jeremymatthewwerner/halloween-watchful-creature/README.md

# 🎃 Halloween Watchful Creature

A friendly talking porch decoration. It **sees** trick-or-treaters, **compliments their costumes** with kid-friendly jokes, and **chats** with them, powered by OpenAI **GPT-Live**. Its LED eyes glow, pulse and sparkle while it talks. How spooky it gets is up to you (the **Spookiness** dial).

The first character is **Jacques O'Lantern, Pumpkin Critic**: a dapper pumpkin in a top hat, round spectacles and a bow tie who gives every costume a big, silly verdict ("a gold medal!", "three thumbs up, and I don't even have thumbs!"). He talks kid-first, in simple words, and only does his full fancy-food-critic routine for grown-ups who play along. Sir Reginald Bonesworth (skeleton butler) and Edgar the Raven (rhyming critic) are included, and you can switch characters from the dashboard.

**What it does**
- **Greets fast:** starts waking the moment someone appears, says a quick hello while the camera's look is still being described, then praises each costume's **standout detail**.
- **Keeps big groups moving:** for 4 or more visitors, or a group that keeps growing into a line, it gives one quick group welcome, a shout-out to one or two standout costumes and a group moment ("everybody say trick or treat!"), with no mini-game, instead of going costume by costume.
- **Notices change:** new visitors, a second person joining, someone swapping in, and the same person back in a different hat (a playful remark), or back soon (silence) or after a while (a "welcome back").
- **Doesn't repeat itself:** remembers what it said tonight across voice sessions, varies its openings and verdicts, and keeps running gags ("visitor number 50!", "the fourth dinosaur tonight!").
- **Plays:** an occasional riddle for "trick", a roar contest, or "guess what I am".
- **Lets you steer:** quick modes (Candy's low/out, Toddler mode, Back in 5, Last call), a spookiness dial, a voice picker, a kill switch and "make it say…", from the dashboard or **your phone**.
- **Looks after itself:** a watchdog recovers a stuck camera or page, and alerts can **push to your phone**. If Wi-Fi or OpenAI goes down, it greets visitors with **recorded greetings** and switches back to its live voice by itself.
- **Keeps a record:** a daily log with a snapshot of each greeting, a **costume gallery** for the family, and a **night recap** (groups, busiest half hour, top costumes, best lines), with one push to your phone when the night is over.
- **Rehearsal mode:** test greetings with sample photos, without walking in and out of frame.

| Doc | What's in it |
|---|---|
| [docs/PLAN.md](docs/PLAN.md) | Goals, decisions, milestones |
| [docs/DESIGN.md](docs/DESIGN.md) | Architecture, behavior, engines, body protocol |
| [docs/BOM.md](docs/BOM.md) | Bill of materials |
| [docs/SHOPPING_LIST.md](docs/SHOPPING_LIST.md) | Where to buy everything (Burlingame, CA route) |
| [docs/PROP_BUILD.md](docs/PROP_BUILD.md) | Building the pumpkin, wiring the eyes, porch checklist |
| [docs/templates/pumpkin-carving-template.pdf](docs/templates/pumpkin-carving-template.pdf) | Printable, actual-size carving template |
| [docs/PI_MODE.md](docs/PI_MODE.md) | Running on a Raspberry Pi 5 |
| [docs/SOAK_TEST.md](docs/SOAK_TEST.md) | The soak test: a whole evening at high speed, against a mock OpenAI |

## Quick start (Mac)

1. **Install Node.js 22+**. To keep it isolated from the rest of your Mac, use [nvm](https://github.com/nvm-sh/nvm): it installs to `~/.nvm`, no sudo needed. Run `nvm install && nvm use` in the project folder, which picks up `.nvmrc`. Or use `brew install node`, or the installer from nodejs.org. Also install **Google Chrome**. All project dependencies install into `./node_modules` only.
2. **Get the code and install dependencies:**
   ```bash
   git clone https://github.com/jeremymatthewwerner/halloween-watchful-creature.git
   cd halloween-watchful-creature
   npm install
   cp .env.example .env
   ```
3. **Add your OpenAI key:** edit `.env` and set `OPENAI_API_KEY=sk-...`. Also set a monthly spend limit on the OpenAI project.
4. **Check your setup** (Node, key, model access, a test vision call, Arduino):
   ```bash
   npm run doctor
   ```
5. **Run it:**
   ```bash
   npm run dev
   ```
6. **Open Chrome at http://localhost:5173**, click **🎃 Wake the creature**, and allow camera and microphone access.
7. **Walk up to the camera.** It greets you and compliments your outfit. Try asking "what am I dressed as?" or "tell me a joke".

The Mac's built-in camera and mic are fine for testing. Once the porch gear is plugged in (the C920 webcam, whose built-in mics are the ears, and the speakers on a USB sound card; a USB speakerphone works too), choose them under **Settings** on the dashboard. Your choices are remembered by name, so re-plugging into another port or hub is fine.

### Halloween night
```bash
npm run build
caffeinate -dis npm start     # keeps the Mac awake; serves the dashboard at http://localhost:8787
```
Then open **http://localhost:8787** in Chrome and click **Wake the creature**. For an unattended night, start Chrome with the autoplay flag shown under **Watchdog** below, so it can wake itself after a reload, and set up the **phone remote and alerts**.

## Dashboard
- **Live video** with person boxes: green means close enough to greet, grey means too far. Tune the distance with **Settings → How close counts as a visitor**.
- **Status pills:**
  - engine;
  - session state (asleep, connecting, awake);
  - body state (sleeping, idle, listening, thinking, speaking);
  - running **cost**.
- **Eye preview:** an on-screen copy of the two NeoPixel Jewels, pixel by pixel, using the same colors and animations as the firmware, so you can test without the Arduino.
- **👋 Greet now:** forces a greeting.
- **🛑 Sleep (kill switch):** ends the voice session and ignores visitors until you press Wake.
- **Quick modes:** one-tap buttons that change how the creature acts until you tap them again. A lit button (marked **ON**) is on. They're remembered for the evening, even if you reload the page, and are sent again each time a new voice session starts.
  - **🍬 Candy's low:** asks everyone to take just one piece.
  - **🚫 Candy's out:** says sorry, kindly, that the candy is gone, and still compliments costumes.
  - **🧸 Toddler mode:** extra gentle, nothing spooky, very short lines.
  - **⏳ Back in 5:** tells visitors the candy helpers will be back in a few minutes.
  - **🌙 Last call:** greets as usual, then says a warm goodnight.

  Each tap is noted in the Conversation panel and today's log.
- **Spookiness:** a dial under the quick modes for how spooky the creature is tonight. It works the same way as the quick modes: it applies right away, is sent again to each new voice session, and is remembered for the evening.
  - **🌼 Gentle (0):** cheerful and sweet, nothing scary at all.
  - **🎃 Playful (1, the default):** the creature's normal, light spooky fun.
  - **👻 Spooky (2):** eerie voice moments, creaky laughs and spooky jokes, then friendly again.
  - **🦇 Scary (teens) (3):** creepier and more dramatic, but never gory, cruel or mean. If a young child walks up, or anyone seems scared or says so, it switches to gentle by itself.
  - **🕰️ Auto:** follows the clock: gentle until 7 pm, playful from 7, spooky from 8 pm. Auto never picks Scary.

  The level also flavors the greetings' variety twists (a sunny hello when gentle, an eerie pause or a ghost-story line when spooky or scary). **🧸 Toddler mode** wins over the dial: while it's on, the creature is gentle (plus tiny words and very short lines), whatever the dial says, and goes back to the dial's level when you turn it off. Gentle is for a calm evening; Toddler mode is for when very little kids are at the door.
- **Make it say…:** type a line and the creature says it in character.
- **Voice:** a picker listing every voice the current engine can use. Each shows what OpenAI's docs say about it (for GPT-Live: language, regional influence, presentation and source; the docs don't describe tone) and our own notes from testing. English voices come first; the other-language voices carry their language's accent.
  - The voice in effect is marked **current**, with where it comes from. Order: your pick here (remembered in this browser, per engine) > `VOICE` in `.env` > the character's default. **Use default** forgets your pick.
  - A new voice starts with the next voice session. While a session is running with another voice, **🔄 Restart voice session now** ends it; if visitors are there it reconnects right away with the new voice.
  - The server only accepts voices on its list (`shared/voices.ts`); anything else is ignored and logged.
- **Conversation:** live transcript plus system notes.
- **Server log:** the server's terminal output, live. Its links open **today's log**, today's **costume gallery**, the **night recap** and **all logs**. Under them: whether snapshots are on and how long they're kept, and **🗑️ Delete all snapshots now** (see **Privacy** below).
- **Alerts:** health problems (see below), shown only when there are any.
- **Between visitors** (both free: local audio only, they never open the voice session), each with a toggle in **Settings** that's remembered:
  - **Spooky sounds:** every 20–60 s on an empty porch, a quiet creaky door, owl, distant thunder, wind, cackle, wolf howl or church bell, synthesized in the browser (no audio files).
  - **Call out to people walking by (lure mode):** when someone is in view but too far to count as a visitor (a grey box), the pumpkin plays one of 14 recorded call-outs ("Psst! Over here! Come get your costume reviewed!"), never the same one twice in a row, at most once per **Seconds between call-outs** (default 45, plus up to 15 s at random). It waits 30 s after visitors leave or the creature talks, so it doesn't call back kids who just left.
  - Both stop the instant someone comes close or the creature speaks, stay silent while the kill switch is on, and play through the selected **Speaker**.
  - **Eyes:** during a call-out the eyes (and jaw) pulse with the recording, as they do with the live voice. Ambience only gets a blink.
- **Recorded clips in the creature's voice:** call-outs and offline greetings are read by OpenAI text-to-speech (`gpt-4o-mini-tts`), whose voices aren't GPT-Live's. When the dashboard wakes, and whenever you pick a voice, the server makes the clips in the closest TTS voice (about a cent, once per voice), caches them in `clip-cache/` (gitignored; `CLIP_CACHE_DIR`, `none` turns this off) and the dashboard switches to them. Until then, or if that isn't possible (no key, no network, a voice it knows nothing about), it uses the bundled clips (voice `cedar`). The mapping is in [docs/DESIGN.md](docs/DESIGN.md) ("Recorded clips in the session voice"): for example `ripple` is read by `cedar` with a light Australian accent. Making clips is dashboard-only: the phone remote can't trigger it.

### Offline mode (Wi-Fi or OpenAI down)
If the voice session can't start (an error, no network, or no connection within 5 s of a visitor arriving), or it drops mid-visit and won't come back, the pumpkin plays one of 16 short **recorded greetings** ("Happy Halloween! Ooh, what a great costume!") instead of going silent, with its eyes pulsing to the recording.
- Never the same greeting twice in a row, and at most one every 20 s (a group stepping out and back doesn't get a string of them).
- It keeps trying the live voice in the background, after 5 s, then 10, 20, 40 and every 60 s, and switches back the moment it works: visitors who only heard a recording then get a proper live greeting. With the porch empty, a successful check closes the session again right away.
- The status pill shows **offline: recorded greetings**. Going offline and coming back are logged in the Conversation panel and the server log, and raise a **Voice offline** alert (pushed to your phone at most once per 15 minutes, however often it flaps). While offline, the watchdog's separate "voice session failing" alert is held back.

## Phone remote and alerts
Watch and steer the creature from the couch, and get a push on your phone when something breaks. The dashboard on the creature's computer stays the brain: the phone's buttons go through the server to the dashboard, and its status comes back the same way.

### Phone remote
1. In `.env`, set a PIN of at least 6 characters (longer is better), then restart the server:
   ```
   REMOTE_PIN=pick-something-long
   ```
   With a PIN set, the server also listens on your home network (all interfaces, same port). Without one, it only answers this computer, as before.
2. Find the computer's address: on a Mac, **System Settings → Wi-Fi → Details** (or `ipconfig getifaddr en0`); on the Pi, `hostname -I`.
3. On your phone, on the same Wi-Fi, open **`http://<that address>:8787/remote`** and enter the PIN. Tip: add it to your home screen.
   - This works the same in development (`npm run dev`) and on Halloween night (`npm start`): the phone always talks to the server on port 8787, never to the Vite dev server on 5173 (that one only serves this computer, since it hands out project files without a PIN).
   - macOS may ask whether to allow incoming connections for `node`: allow it.

The remote shows whether the creature is awake, asleep (kill switch) or waiting for a tap, visitors at the door, the voice session, the Arduino, today's awake minutes and estimated cost, and the latest alerts. Its buttons: **🛑 Sleep / ▶️ Wake** (the kill switch), **👋 Greet now**, **Make it say…**, the **quick modes**, and links to today's log, the costume gallery, the night recap and all logs.

**Security:**
- LAN access is off unless `REMOTE_PIN` is set. Setting `HOST=0.0.0.0` without a PIN is ignored (the server stays on 127.0.0.1 and says so). `HOST` can still pick a specific address when a PIN is set.
- Every request from another device needs a signed-in session: all `/api` routes (including logs, snapshots and galleries), the `/recap` pages and the `/ws` socket. Only the PIN page and the PIN check itself are open; a page opened without a session (like the recap link in a push) goes to the PIN page first. The dashboard on the creature's computer (loopback, addressed as `localhost`) needs no PIN.
- The PIN is sent once, in the body of a POST, and swapped for an `HttpOnly`, `SameSite=Strict` session cookie (24 hours; restarting the server signs phones out). It's compared in constant time and never logged or put in a URL.
- Wrong PINs: 5 per phone per 15 minutes, and 20 from all devices together, then sign-in locks for the rest of the 15 minutes.
- Even signed in, the phone can't use the dashboard-only routes: it can't start voice sessions, call the vision model, drive the Arduino or delete snapshots. The existing origin check still applies.
- It's plain HTTP on your home network, so anyone who can watch your Wi-Fi traffic could see the PIN and cookie. Use it on a home network you trust, not on public Wi-Fi.

### Watchdog
The dashboard watches itself and recovers:
- **Camera frames stopped:** it restarts the camera; if frames don't come back within 20 s, it reloads the page.
- **Person detector errors** (many in a row, or it failed to load): reloads.
- **Voice session failing to start** 5 times in a row: alerts, and reloads if this computer is known to wake without a click (see below).
- **Page frozen:** a frozen page can't fix itself. The dashboard checks in with the server every 2 s; after 45 s of silence the server raises an alert. On the Pi, `scripts/pi/kiosk.sh` also restarts Chromium when the dashboard has been silent for 90 s.

At most 3 automatic reloads per hour (never in the first minute after loading), then it only alerts. A page that was awake in the last 15 minutes wakes again by itself after a reload, with the kill switch as it was.

**Sound after a reload:** browsers block sound until someone clicks the page. If that happens, the dashboard waits, shows *Click to wake* and raises a **Dashboard needs a tap** alert. Pressing **Wake** on the remote retries, but a tap on the phone can't unblock sound on another device's browser: someone has to click the dashboard once. For unattended use, start Chrome with:
```bash
# Mac
open -na "Google Chrome" --args --autoplay-policy=no-user-gesture-required "http://localhost:8787/?autowake"
```
The Pi kiosk already uses this flag. The setting only lasts while that Chrome window runs, so quit Chrome fully first.

### Alerts
Alerts show on the dashboard and the remote: camera lost, person detector failed, Arduino disconnected, vision errors piling up, voice session failing, voice offline (playing recorded greetings), daily cost cap reached, the watchdog reloading the page, the dashboard needing a tap, and the dashboard not checking in. Repeats of a problem that's still going are counted, not listed again, and they're marked when they clear up by themselves.

**Push to your phone (optional), with [ntfy](https://ntfy.sh):**
1. Install the **ntfy** app (iOS or Android).
2. Make up a long, random topic name: anyone who knows it can read your alerts. For example, run `openssl rand -hex 12` and use `jacques-<that>`.
3. In the app, tap **+** and subscribe to that topic (server `ntfy.sh`).
4. In `.env`, set `NTFY_TOPIC=jacques-<that>` and restart the server.

Pushes are short fixed messages (like "Camera stopped. Check the USB cable…"): never photos, transcripts or anything about visitors. Each kind of problem is pushed at most once per 15 minutes, and at most 6 pushes per hour in total.

**End-of-night push:** once per evening, a message with the headline stats ("Jacques met 43 groups tonight (about 97 people), busiest 7:00–7:30 pm (9 groups). Awake 1 h 42 min."). It goes out when the kill switch has been on for `RECAP_SLEEP_MINUTES` (default 15; use **Back in 5** for short breaks), or at `RECAP_AT` (e.g. `22:00`) if that comes first. Numbers and times only, never photos or costumes. With `REMOTE_PIN` set it adds a link to the recap at this computer's home-network address (or `REMOTE_URL`); tapping it asks for the PIN if the phone isn't signed in. Without a PIN there's no link, since the phone can't reach the server. Nights with no visitors send nothing, and a `recap-sent.txt` in the day's folder stops a restarted server from sending it twice. `NTFY_SERVER` and `NTFY_TOKEN` are for a self-hosted ntfy server or a protected topic.

### Rehearsal mode (testing without walking into frame)
**Settings → 🎭 Rehearsal (developer)** pretends visitors walk up, using sample images instead of the camera. Wake the creature first, then tick **Rehearsal on**.
- **Sample images:** upload image files (kept in the page's memory only, never saved), and/or click greeting snapshots from a day's log (read from `/api/session-logs`). Click a chosen image to make it the camera frame.
- **✨ Generate visitors:** made-up trick-or-treaters drawn by OpenAI's image model, so you can rehearse costumes and group sizes nobody at home has. Pick how many images (1–6) and either random group sizes or a fixed one (1–4); the button shows the **estimated cost before you click**. Each image is its own random scenario: 1–4 people in distinct costumes from a varied list (dinosaur, witch with a purple hat, astronaut, ghost sheet, invented superhero, princess, pirate, skeleton, bumblebee, ninja, unicorn, firefighter, cardboard robot, mermaid, wizard, knight, and more, plus a grown-up with no costume and a teen in a lazy costume), with bright, dim, backlit or jack-o'-lantern lighting. The prompts ask for a clearly fictional, stylized picture (animated-film render, storybook illustration or claymation), never a photo: generic cartoon faces that don't resemble any real person, no famous or trademarked characters, nothing scary, and no text in the image.
  - **Cost:** about **$0.01 per image or less** (`gpt-image-2.5-flare`, `low` quality, 1536×1024 JPEG; billed at $5 per 1M text input tokens and $30 per 1M image output tokens). The panel's estimate is `REHEARSAL_IMAGE_COST_USD` (default 0.01); after each image the server logs what it really cost, from the token usage the API reports, and the gallery shows the total. Generating is one request at a time, at most 6 per click.
  - **Cached, so each picture is paid for once:** images go in `rehearsal-cache/` (gitignored; `REHEARSAL_CACHE_DIR` to move it, `none` to turn generating off) as `<id>.jpg` plus `<id>.json` with the scenario (group size, costumes, lighting, model, cost). It's its own folder rather than under `logs/` because these aren't visitor photos: they shouldn't show up in the day logs or the costume gallery, and deleting old log days shouldn't throw away pictures you paid for. The gallery lists them all; click one to add it to the chosen images, or **×** to delete it from the cache.
  - **Automatic person count:** a generated image carries its group size, and the pretend detections follow it: **🚶 arrives** with a group of 3 gives the tracker 3 people, a **🔁 swap** to an image of a different group changes the count (so a swap from 1 to 3 people is a gap and then a "grew"), clicking another generated image while visitors are in view switches the count right away, and **👯 More visitors join** switches to the next image of a bigger group (or, if there's none, adds one person to the count). Uploads and log snapshots have no known group size, so they keep the button-driven count.
  - Settings: `REHEARSAL_IMAGE_MODEL` (default `gpt-image-2.5-flare`), `REHEARSAL_IMAGE_QUALITY` (`low`), `REHEARSAL_IMAGE_SIZE` (`1536x1024`, landscape like the webcam; the panel scales it to 768 px wide like a camera frame). The endpoints (`GET /api/rehearsal/generated`, `POST /api/rehearsal/generate`, `DELETE /api/rehearsal/generated/<id>`) sit under `/api` with the other billed endpoints, so they get the same local-only protection.
- **🚶 Visitor arrives**, **👋 Leaves**, **👯 More visitors join** (a "grew"), and **🔁 Swap to next image**: the visitor steps out of view for 3 s and comes back as the next image, which exercises the gap check and the vision model's NEW/CHANGED verdicts.
- **▶️ Run script:** arrive, wait 20 s, swap, wait 10 s, leave, wait 15 s, come back (a "returned").
- While it's on, a red **REHEARSAL — not the real camera** banner covers the video, and real detections are ignored (the detector isn't even run). Untick it to go back to the camera.
- The real tracker and director run, with their real timings: "left" counts after 8 s out of view, and a joiner is greeted only 30 s after the last greeting.
- **It uses the real voice and vision APIs**, so it costs money like real visitors.
- **Logs:** vision lines say `[REHEARSAL]`, and conversation lines from the rehearsal start with `[REHEARSAL]` in `log.txt` and are greyed in `log.html`. **No snapshots are saved** for rehearsal looks: the images are uploads (meant to stay in memory) or log snapshots (already saved), and leaving them out keeps the costume gallery clean. The gallery also skips rehearsal lines. Rehearsal greetings don't count toward tonight's visitor tally or the "don't repeat yourself" memory.

How it works: `web/rehearsal.ts` sits behind two small seams in `web/main.ts`: the frame source (`capture`) and the person detections fed to the tracker. Everything downstream is unchanged.

## Logs on disk
Each day gets a folder in `logs/` (for example `logs/2026-10-31/`). Server restarts append to the same day.
- `log.html`: everything in one readable page: server lines, what visitors and the creature said, system notes, and a **snapshot** of each greeting with the vision verdict (click a snapshot for full size).
- `log.txt`: the same as plain text, for `grep`.
- `snapshots/`: the camera frame of each greeting, deleted after a week (see **Privacy** below).

The **costume gallery** (`/api/session-logs/<day>/gallery.html`, linked from the dashboard and from **All logs**) turns a day into a grid of greetings: each snapshot with what the camera saw and the creature's best line from that moment. Click a costume, or **▶️ Slideshow**, to see them big (arrow keys move, Esc closes). It's built from the day's `log.txt` each time you open it, so there's nothing extra to save. It's for the family only: it shows other people's kids, so it has no share or upload buttons.

The **night recap** (`/recap/<day>`, or `/recap` for the latest evening; linked from the dashboard, the remote and **All logs**) is the morning-after summary, also built from `log.txt` on request, with rehearsal lines left out:
- **visitor groups** and **roughly how many people**: each greeting of new visitors (walking up, joining a group, or someone new found by a camera check) is a group, counted with the person detector's number, or the number the camera's description mentions; the page explains the method and its limits;
- the **busiest half hour**, with a bar per half hour;
- the **top costumes**: one snapshot per group, preferring new greetings with a vivid "standout:" detail, skipping the same group seen again (a snapshot deleted since shows a placeholder);
- a few of the creature's **best lines**, and how long it was **awake** (voice session open) and **on duty**.

It shows kids' photos, so it sits behind the same rules as the gallery: this computer only, or a phone signed in with the PIN.

### Privacy: photos of visitors
The snapshots are photos of other people's kids, so they're kept on your computer only, and not for long:
- **Kept for a week, then deleted** (`SNAPSHOT_RETENTION_DAYS`, default `7`): when the server starts, and then once a day, it deletes the photos of every day more than 7 days old. Halloween's photos stay through Nov 7, so the family can enjoy the gallery the week after, and are gone on Nov 8. Only the photos go: `log.txt` stays, `log.html` shows a small "📷 photo removed after 7 days" in their place, and the gallery still shows what the camera saw and what the creature said. `0` (or `off`) keeps photos forever.
- **Turn them off** with `SNAPSHOTS=off`: no camera frames are written to disk at all. The vision captions still go in the log, and the gallery says snapshots are turned off and shows words only. (The older `LOG_SNAPSHOTS=false` still works.)
- **Delete them all now:** the dashboard shows the current setting under the log links (for example "📷 Snapshots on, kept 7 days"), with a **🗑️ Delete all snapshots now** button. It asks first, then deletes every day's photos, today's included, and keeps the logs. Only the dashboard on the creature's computer can do this, not the phone remote.
- `LOG_DIR=none` keeps no logs at all (no gallery either). Deleting a day's folder removes that day completely.

Upgrading from a version without retention: the first start deletes photos older than 7 days. Set `SNAPSHOT_RETENTION_DAYS=0` first if you want to keep them.

The clean-up only ever deletes inside `LOG_DIR`: files named like a snapshot (`18-05-09-arrived.jpg`) in the `snapshots/` folder of a folder named like a day (`2026-10-31`). It never follows symlinks.

## How it saves money
The voice session only runs while someone is at the porch.
- A free, local person detector watches the camera.
- When someone walks up, the app wakes the voice session (about 1–2 s) and sends **one snapshot** to describe the costumes.
- When the porch has been empty for 3 minutes (`IDLE_CLOSE_SECONDS`), the session closes.
- The mic is muted whenever nobody is there.

GPT-Live costs about **$0.05 per minute** of voice, plus small vision-model calls.

## Configuration (`.env`)
| Setting | Default | Meaning |
|---|---|---|
| `OPENAI_API_KEY` | (required) | Server-side only; never sent to the browser |
| `CHARACTER` | `pumpkin` | `pumpkin`, `reginald` or `raven` (the dashboard picker overrides it) |
| `ENGINE` | `live` | `live` = GPT-Live; `realtime` = gpt-realtime-2.1 (fallback with native image input) |
| `VISION_MODEL` | `gpt-6-luna` | Vision-capable Responses model that describes costumes for GPT-Live |
| `VISION_REASONING_EFFORT` | `low` | Leave empty for non-reasoning models |
| `VOICE` | (character's) | Fallback voice, e.g. `vesper`, `gleam`, `meridian`. Used when nothing is picked in the dashboard's **Voice** picker (which overrides it); beats the character's default |
| `BODY_SERIAL_PORT` | `auto` | `auto` finds the Arduino; `none` disables it; or a device path |
| `BODY_MODES` | `eyes` | Any of `eyes,jaw,relay` |
| `IDLE_CLOSE_SECONDS` | `180` | Close the voice session after the porch has been empty this long |
| `BACKGROUND_FRAME_SECONDS` | `30` | While visitors stay, refresh what it sees this often |
| `MAX_VOICE_MINUTES_PER_DAY` | `240` | Safety cap. After this many awake minutes in a day (about $12 on GPT-Live), it goes to sleep until you press Wake. |
| `REMOTE_PIN` | (off) | Turns on the phone remote: the server listens on your network and asks other devices for this PIN (6+ characters) |
| `HOST` | `127.0.0.1`, or `0.0.0.0` with a PIN | Address to listen on; anything other than loopback needs `REMOTE_PIN` |
| `NTFY_TOPIC` | (off) | ntfy.sh topic for push alerts; make it long and random |
| `NTFY_SERVER` / `NTFY_TOKEN` | `https://ntfy.sh` / (none) | Self-hosted ntfy server, or a token for a protected topic |
| `LOG_DIR` | `logs` | Folder for the daily logs and snapshots; `none` keeps no logs (and no gallery) |
| `SNAPSHOTS` | `on` | `off` keeps the logs (with the vision captions) but writes no photos. The older `LOG_SNAPSHOTS=false` also turns them off |
| `SNAPSHOT_RETENTION_DAYS` | `7` | Delete photos of days older than this (at start, then daily); `log.txt` is kept. `0` or `off` keeps them forever |
| `RECAP_AT` | (off) | Local time (like `22:00`) to push the night recap's headline, if the kill switch hasn't already. Needs `NTFY_TOPIC` |
| `RECAP_SLEEP_MINUTES` | `15` | Push the recap once the kill switch has been on this long; `off` to only use `RECAP_AT` |
| `REMOTE_URL` | (guessed) | How the phone reaches this computer, e.g. `http://192.168.1.5:8787`, for the recap link. Only used with `REMOTE_PIN` |
| `CLIP_CACHE_DIR` | `clip-cache` | Where call-outs and offline greetings in the picked voice are cached; `none` uses only the bundled clips |

Set `BODY_DEBUG=1` to log the commands sent to the Arduino.

## Development
```bash
npm test          # unit tests (tracker, director, engines, vision prompts, logs, gallery, recap, remote, watchdog, body protocol, …)
npm run typecheck
npm run build
npm run soak      # soak test: a whole Halloween evening in about 75 minutes, against a mock OpenAI (free)
```

**CI:** on every pull request, GitHub Actions (`.github/workflows/ci.yml`) runs the tests, typecheck and build, and compiles the Arduino firmware for the Uno in both eye modes (NeoPixel Jewels and plain LEDs).

**Soak test:** `npm run soak` runs the real server and the real dashboard (headless Chrome, fake camera and mic, rehearsal mode, faked WebRTC) against a local mock of OpenAI, plays about 140 visitor groups plus phone-remote presses, reconnecting streams and an outage, and checks memory, timers, streams, disk and stalls. No key needed and no real API calls. `--hours 0.5` for a quick run. Details and what it can't cover: [docs/SOAK_TEST.md](docs/SOAK_TEST.md).

**Layout:**
- `server/`: Node server that starts sessions, runs the vision backend and drives the Arduino.
- `web/`: the Chrome dashboard, containing:
  - the camera and person detector;
  - visitor tracking;
  - the director;
  - the voice engines.
- `prompts/`: the shared rules plus one file per character.
- `firmware/`: the Arduino sketch.
- `tests/`: unit tests.
- `scripts/make-lure-clips.ts`: one-time generator for the bundled recorded clips (`npx tsx scripts/make-lure-clips.ts pumpkin`, `--kind lure|greeting` for one kind). It uses OpenAI text-to-speech (`gpt-4o-mini-tts`, voice `cedar`) and writes MP3s plus `manifest.json` to `web/public/lure/<character>/` (call-outs) and `web/public/greeting/<character>/` (offline greetings). The lines live in `server/clips.ts`, which the server also uses to make the per-voice sets. The clips are committed, so the app doesn't need the script. Re-running only regenerates new or edited lines (`--force` redoes all). All 30 pumpkin clips cost about 2 cents. Characters without clips skip lure mode and stay quiet in offline mode.

### Add a character
Copy `prompts/characters/pumpkin.md` to `prompts/characters/<id>.md` and edit:
- the frontmatter: name, voice, eye colors and eye style, and `games: on` if it should play the trick-or-treat mini-games (`prompts/games.md`);
- the persona below it.

It appears in the dashboard's character picker.

## Troubleshooting
- **It hears itself or echoes** (🧒 lines in the Conversation panel repeating its own words):
  - keep the volume reasonable;
  - point the speaker away from the webcam's mics, or move them apart inside the pumpkin;
  - a USB speakerphone with hardware echo cancellation fixes it for good.
- **Speakers are faint or hum:**
  - push the 3.5 mm plug **all the way** into the USB sound card's headphone jack (a half-seated plug is faint and hums);
  - set the Mac's output volume for the sound card to 100% and use the speaker's own knob for loudness;
  - plug the speakers and the USB hub into the same power strip.
- **The voice sounds flat or wrong:** try another voice in the dashboard's **Voice** picker (see the notes there). The persona's delivery rules ask for big, bouncy energy, but some voices carry it better than others.
- **It greets people on the sidewalk:** raise "How close counts as a visitor".
- **It doesn't notice people at night:** add light on the visitors.
- **"Could not start voice session"** (and **offline: recorded greetings**): visitors still get recorded greetings, and it retries by itself; to fix the cause:
  - check the internet connection;
  - check `OPENAI_API_KEY`;
  - check that your project has GPT-Live access;
  - read the server log for OpenAI's error detail;
  - try `ENGINE=realtime`.
- **"Saved camera … isn't connected: using the default":** the dashboard remembers devices by ID and by name, so re-plugging the gear into another port or hub is usually fine. If it can't find one at all, pick it again in **Settings**.
- **The Arduino isn't found:**
  - close the Arduino IDE's Serial Monitor;
  - check the server log for `[body]` lines;
  - set `BODY_SERIAL_PORT` to the port shown in the Arduino IDE.
