jeremymatthewwerner/halloween-watchful-creature/docs/SHOPPING_LIST.md

# Shopping list by store (stock checked Sat 2026-10-17, evening)

**How each store was checked:**
- **Central Computers** and **Home Depot:** I read each store's own per-store inventory on their websites. The counts below are what those pages showed for the **San Mateo** stores when I checked.
- **Michaels:** its website shows products and prices, but not per-store stock without picking a store. Items are listed, but stock isn't confirmed.
- **Best Buy** and **Micro Center:** their sites block automated checks, so nothing there is confirmed. Check their apps with your store selected.

Store stock changes during the day. "In stock: 2" means grab it early or call ahead.

## Route
| # | Store | Address | Why |
|---|---|---|---|
| 1 | **Central Computers** | 2727 S El Camino Real, San Mateo · 650-345-5888 | Webcam, Arduino kit, USB cables and hub, solder, all the Pi parts (verified) |
| 2 | **Michaels** | 2925 S El Camino Real, San Mateo (a block away) | Pumpkin and costume bits |
| 3 | **Home Depot #632** | 2001 Chess Dr, San Mateo | Soldering iron, light, cord, ties, tape, Velcro (verified) |
| 4 | **Best Buy** | 1127 Industrial Rd, San Carlos | **Only the speakerphone.** No store I could check stocks one. |
| — | **Order online now** | adafruit.com | NeoPixel eye LEDs. No local store had them in stock (Micro Center couldn't be checked). |

---

## 1. Central Computers, San Mateo (verified stock)
| ✔ | Item | Store SKU | Price | In stock (San Mateo) | If they're out |
|---|---|---|---|---|---|
| [x] | **Logitech C920S webcam** | VGALOGC920SR | $59.99 | 5 | SF has 11, Sunnyvale 23. Or Best Buy (Logitech 960-001257). |
| [x] | **"Raspberry Pi Starter Kit"**. Despite the name, this is the **Arduino kit**: UNO board, USB cable, breadboard, **9g servo**, **relay module**, LEDs, resistors, jumpers. | DIY-JIARPISK | $29.95 | 3 | Sunnyvale 2, East Bay 6. Or the Elegoo kit at Micro Center (SKU 961201). |
| [x] | **Unitek U304A USB-C → USB-A active extension, 5 m (16.5 ft).** Plugs straight into a USB-C Mac, so no adapter is needed. | CAB-UNU304A1 | $24.95 | 7 | Unitek Y-277 USB 2.0 active extension 5 m (CAB-UY2775M1, $14.95, 6 in stock) **plus** a Mcdodo OT-3800 USB-C→USB-A adapter (ADA-OT3800A1, $5.95, 13 in stock) |
| [x] | **Unitek Y-HB03001 USB 3.0 4-port hub with 12V 2A power adapter** | ADA-UNY03001 | $22.95 | 11 | Unitek Y-3184 7-port hub with 12V 3A adapter (ADA-UNY3184R, $29.95, 9 in stock) |
| [x] | ~~Lead-free rosin-core solder, 0.8 mm~~ → **ordered on Amazon (Oct 18): ZSHX lead-free 0.8 mm**. Original pick: **Lead-free rosin-core solder, 0.8 mm** | MIS-UFKS2825 | $7.95 | 2 | Soldering wire 1.0 mm (MIS-UFSDW12, $2.95, 6 in stock). The Home Depot Weller kit also includes a little solder. |
| [x] | ~~20 cm jumper wire set~~ (skipped: the kit has jumpers), 120 pcs, M-M/M-F/F-F (extra wires for the eyes) | DIY-JF20CMJC | $7.95 | 26 | 30 cm set (DIY-JF30CMJC, $9.95, 7 in stock) |
| | **Speaker plan B** (only if no store has a USB speakerphone). The C920S's built-in mics become the ears, and Chrome's echo cancellation keeps it from hearing itself. | | | | |
| [x] | **Logitech Z150 2.0 speakers, 6 W** (3.5 mm input, plugs into the wall) | CDDLOGZ1501R | $34.99 | 1 | Logitech Z207 10 W, Bluetooth + 3.5 mm (CDDLOGZ2071R, $69.99, 5 in stock). Skip the S-150 USB speakers: too quiet for a porch. |
| [x] | ~~Zoweetek S03~~ → **bought Unitek Y-247A USB sound card instead** (same job). Original pick: **Zoweetek S03 USB sound card** (goes in the hub at the pumpkin and drives the speaker's 3.5 mm plug, so no long audio cable) | MIS-VACSS031 | $12.95 | 4 | Any USB-to-3.5 mm audio adapter |
| | **Pi mode parts:** | | | | |
| [x] | **Raspberry Pi 5 8GB board** | DIYRASC1112R | $174.99 | 2 | Sunnyvale 64, Santa Clara 17. Or the CanaKit at Best Buy (unverified). |
| [x] | **Raspberry Pi 27W USB-C power supply** | DIYRASC1153R (white) / DIYRASC1158R (black) | $11.99 | 44 | Generic 27W PD supply (ADA-RPI27WC1, $10.99, 15 in stock) |
| [x] | **Raspberry Pi 5 official case** (has a built-in fan) | DIYRASC1159R | $9.99 | 26 | Aluminum Pi 5 case with fan (DIY-ODSB8071, $15.95, 17 in stock), or the Pi 5 Active Cooler (DIYRASC1148R, $9.99, 92 in stock) |
| [x] | ~~SanDisk Ultra 64GB~~ → **bought SanDisk Extreme 128GB instead**. Original pick: **SanDisk Ultra 64GB microSD** | MEMSAN0646AR | $27.99 | 2 | SanDisk High Endurance 128GB (MEMSAN128QQR, $39.99, 10 in stock) |
| [x] | **Micro-HDMI to HDMI cable, 3 ft** | CAB-ZH4KMHC1 | $7.95 | 92 | Unitek Y-C182 2 m (CAB-UNYC1821, $9.95, 11 in stock) |

Not available at Central Computers: a **speakerphone** (they only list online drop-ship Jabra accessories), **NeoPixels**, a **soldering iron** (accessories only) and hookup wire.

## 2. Michaels, San Mateo (prices from michaels.com; in-store stock not confirmed)
| ✔ | Item | Price seen | Alternate |
|---|---|---|---|
| [x] | ~~Craft pumpkin~~: **bought a 13" hollow carvable plastic craft pumpkin** | | |
| [x] | ~~Black tulle~~ (bought) | | |
| [x] | ~~Costume bits: beret or chef's hat, monocle or round glasses, bow tie~~ | **bought at Diddams** | Michaels' costume aisle also has them (beret ~$4, Adult Satin Costume Bow Tie $1.99) |
| [x] | ~~Glue gun and glue sticks~~ | already have one | |
| [x] | ~~Pumpkin Masters® Craft Pumpkin Carving Tools~~ → **ordered on Amazon (Oct 18), arrives Oct 20**. Original pick: **Pumpkin Masters® Craft Pumpkin Carving Tools** (made for craft pumpkins; usually shelved by the pumpkins) | $4.19 | Pumpkin Masters® Power Saw ($8.39). Or use your own soldering iron as a hot knife (see PROP_BUILD.md). |

## 3. Home Depot #632, San Mateo (verified stock)
| ✔ | Item | Model / Store SKU | Price | In stock | If they're out |
|---|---|---|---|---|---|
| [x] | ~~Soldering iron~~ (already have one) | | | | Weller 30W kit WLIRK3012A / 1006029627 ($29.98, 9 in stock) if yours is dead |
| [ ] | (**on hold until the dusk test**: the porch light may be enough) **HDX 10-1/2 in. heavy-duty clamp light** | HDX105W300-GRD / 596600 | $16.98 | 3 | HDX 8-1/2 in. aluminum clamp light HD-320PDQ12 / 324719 ($12.82, 12 in stock) |
| [ ] | **EcoSmart PAR38 LED flood bulb, selectable color temperature, 2-pack** (set it to warm). It goes in the clamp light. | 14PR383WS6CCT01 / 1012776664 | $19.98 | 65 | EcoSmart A19 2700K 2-pack, A1960927CAWFIL/ECP/2 / 1008818890 ($7.98, 10 in stock). Or a Hampton Bay 900-lumen plug-in LED flood, G09457 / 1002757124 ($44.97, 5 in stock). |
| [ ] | **HDX 25 ft. 16/3 outdoor extension cord, triple-tap end** | HWHD16325F / 1008994910 | $20.98 | 94 | HDX 25 ft. 16/3 orange, 277509 ($15.98, 93 in stock) |
| [ ] | **6-outlet power strip with surge protector, 3 ft** | LTS-06H-2 / 1002628555 | $13.82 | 23 | Commercial Electric 6-outlet wall-mount surge protector LA-9A-8 / 187860 ($14.98, 37 in stock) |
| [ ] | **HDX zip tie assortment, 8/11/14 in., 500-pack** | FT500PK/BL+NC / 1008253660 | $9.98 | 58 | HDX 11 in. UV black 20-pack (1004137717, $4.37) |
| [ ] | **Gorilla black duct tape, 10 yd** | 105631 / 1006232259 | $5.98 | 109 | Gorilla 30 yd black (1006232257, $9.94, 145 in stock) |
| [ ] | **VELCRO industrial strength strips, 4 × 2 in., black, 2-pack** | 90199 / 846910 | $4.27 | 14 | VELCRO sticky-back strips 90075 / 783788 ($3.77, 6 in stock) |

## 4. Best Buy, San Carlos (not verifiable; check the Best Buy app → store: San Carlos)
| ✔ | Item | Model / SKU | Price | Alternate |
|---|---|---|---|---|
| [ ] | (**not needed**: speaker plan B works) **Anker PowerConf USB speakerphone** | A3301 / SKU 6421726 | ~$110–140 | Jabra Speak2 55 or 75, Jabra Speak 510 or 710, Anker PowerConf S3. Any **USB speakerphone with echo cancellation** works. |
| [ ] | (only if Central Computers was out) Logitech C920s webcam | 960-001257 / SKU 6321794 | ~$60–70 | Logitech C922 or C920x |
| [ ] | (optional instead of the Central Computers Pi parts) CanaKit Raspberry Pi 5 8GB Starter MAX | PI5-8GB-MAX256-C4-WHT-RT / SKU 6580288 | ~$180 | Use the Central Computers Pi parts above (verified) |

**If no store has a speakerphone today:** you can still bench-test with the Mac's built-in mic and speakers. Chrome's echo cancellation handles that well. Order the speakerphone for next-day delivery.

## Order online now (in stock at adafruit.com when checked)
- [x] **Adafruit NeoPixel Jewel 7 RGB, #2226**: $5.95 each. **Ordered 4** on Oct 18 (two eyes and two spares). [adafruit.com/product/2226](https://www.adafruit.com/product/2226)
  - Alternate: 2× NeoPixel Ring 12 (#1643, $8.95, in stock).
  - Not RGBW.
  - **Until they arrive**, the firmware has a plain-LED mode: set `EYES_NEOPIXEL 0` and wire one LED from the Arduino kit per eye, on pins D3 and D5 through 220 Ω resistors. They glow and pulse with the voice in a single color.

**Also ordered on Amazon (Oct 18):** 22 AWG silicone hookup wire (arrives Oct 20). The rest of that cart (power strip, duct tape, zip ties, Velcro) was already on hand or skipped; tick off what you have.

## Rough totals
| Group | Cost |
|---|---|
| Central Computers, Mac mode items | ~$150 |
| Central Computers, Pi parts | ~$232 |
| Michaels | ~$30–60 |
| Home Depot | ~$110 |
| Best Buy speakerphone | ~$110–140 |
| Adafruit LEDs | ~$25 with shipping |
| **Everything** | **~$660–720** |
| **Without the Pi** | **~$425–485** |
