jeremymatthewwerner/halloween-watchful-creature/(commit log)

2026-10-17 Add design, bill of materials, prop build and Pi mode docs
    Claude-Session: https://claude.ai/code/session_01R349ShUY5k4HB56eW5xDJo
2026-10-17 Build the GPT-Live porch creature: server, dashboard, characters, firmware
    - Node server: starts GPT-Live (or gpt-realtime) WebRTC sessions, describes
    camera frames with a vision model, drives the Arduino over USB serial
    - Chrome dashboard: local person detection, visitor tracking, director
    (greet, background looks, mic gating, idle sleep, reconnect), cost meter,
    kill switch, operator 'make it say' box, eye preview
    - Characters: Jacques O'Lantern (pumpkin), Sir Reginald, Edgar the Raven
    - Arduino firmware for NeoPixel eyes, jaw servo and animatronic relay
    - Unit tests for visitor tracking, director, body protocol and characters
    C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
2026-10-17 Add setup doctor, greeting nudge, daily cap, Pi setup script and engine tests
    - npm run doctor: checks Node, .env, model access, a real vision call and the Arduino
    - GPT-Live: if a requested greeting doesn't start within 5 s, nudge once
    - Vision: retry without reasoning settings when the model rejects them
    - MAX_VOICE_MINUTES_PER_DAY safety cap (operator can override with Wake)
    - scripts/pi/setup.sh one-shot Raspberry Pi install
    - Tests for both voice engines and the OpenAI request shapes (45 total)
    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
2026-10-17 Shopping list with verified store stock; plain-LED eyes fallback
    Central Computers and Home Depot San Mateo stock read from each store's
    inventory pages; Michaels items and prices from michaels.com; Best Buy and
    Micro Center could not be checked automatically. Firmware gains an
    EYES_NEOPIXEL 0 mode so kit LEDs work until NeoPixels arrive.
    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
2026-10-17 Shopping list: speaker plan B; soldering iron and glue gun already owned
    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
2026-10-17 Docs: plastic craft pumpkin bought; carving notes for plastic
    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
2026-10-17 Pin Node 22 via .nvmrc; document isolated setup with nvm
    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
2026-10-17 Stop repeat greetings
    - Visitor tracker: someone reappearing within 60 s of leaving is the same
    group ('returned', no greeting); slower, steadier group-growth and leave
    thresholds so detection flicker doesn't trigger greetings
    - Prompts: greet each group once; background camera updates are reference only
    - Background frames every 30 s by default
    - Greeting nudge also checks whether the voice was audible, not just transcripts
    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
2026-10-17 Server log panel and daily logs on disk with greeting snapshots
    The dashboard gets a Server log panel that follows the server's console
    output live (SSE at /api/logs, with heartbeats so it reconnects after a
    dev-server restart instead of freezing).
    Each day also gets a permanent log in logs/YYYY-MM-DD/: log.txt, a
    readable log.html, and snapshots/ with the camera frame of each greeting
    next to the vision verdict. The dashboard sends finished Conversation
    lines (visitor and creature speech, system notes) so the log has the
    whole story. Server restarts append to the same day. LOG_DIR=none and
    LOG_SNAPSHOTS=false turn it off; the privacy note in DESIGN.md says so.
    Vision log lines now show th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
2026-10-17 Hedge a return greeting when vision can't check same-or-new
    If the vision call fails (or there's no camera frame) on a "returned"
    event, the creature used to fall through to the new-visitor greeting, so
    someone who just stepped away was greeted as a stranger. Now it says it
    can't see well and asks whether they're back or new. The last greeted
    group is kept, so the next return with a clear look still compares
    against it. The realtime engine gets the same wording for blind returns.
2026-10-18 Cut greeting lag: wake on first sighting, look while connecting, quick hello
    The first sound came about 6 s after someone appeared: 0.7 s to confirm
    the arrival, ~2 s to connect the voice session, then ~2.4 s of vision
    that only started once connected, then the reply.
    - The tracker emits "sighted" as soon as anyone appears on an empty
    porch; the Director starts connecting then (mic still muted) and lets
    the session sleep again after 15 s if nobody arrives.
    - Greetings take a "ready" promise: the engine starts the vision look
    immediately and speaks once the session is open.
    - If vision hasn't answered 250 ms after that, the creature says a quick
    in-character hello first and complimen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
2026-10-18 Remark on costume changes: CHANGED verdict for gap and background checks
    Coming back within 8 s in a different hat counted as a short gap, and
    the gap recheck only asked "different person?", so the vision model
    rightly said SAME and the creature said nothing.
    Gap and background checks now answer NEW, CHANGED (same people, a hat,
    mask, cape, wig or prop put on, taken off or swapped) or SAME. CHANGED
    gets one quick playful remark, at most once a minute, a snapshot in the
    log, and later checks compare with the new look. On a return, CHANGED
    counts as NEW, as before.
2026-10-18 Always remark on costume changes after a gap; cap only background looks
    Someone stepping out and back in with a pumpkin in front of their face
    got no remark, because the 30 s cap counted the previous hat remark 20 s
    earlier. A change found by a gap recheck is a deliberate entrance, so it
    always gets a remark; the cap now only applies to changes spotted by
    background looks, which is the chatter it was meant to prevent.
2026-10-18 Find re-plugged devices by name; never mistake a hub's port for the Arduino
    - The dashboard insisted on the camera's exact saved id. After moving
    the webcam to another hub it got a new id, so getUserMedia failed with
    an OverconstrainedError and a blank "Camera failed:". Camera, mic and
    speaker are now remembered by id and name, found by id, else by name,
    else the default (logged), and errors show their name.
    - Arduino auto-detect fell back to any "usbmodem" port when no known
    board was plugged in, and grabbed a USB-C hub's billboard device. The
    name fallback now only applies to ports that report no USB vendor.
    - Build guide: stop the server before uploading, how to spot the right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
2026-10-18 Gamma-correct plain-LED eye brightness so states look distinct
    The plain LEDs were driven with linear PWM, so "sleeping" (25%) looked
    about half as bright as full and the states blurred together. Brightness
    now goes through a 2.8 gamma curve: sleeping is a faint ember (5/255),
    the idle flicker and thinking pulse swing much more, and speaking goes
    dark between words and bright on loud ones. NeoPixel output unchanged.
2026-10-18 Add a printable, actual-size pumpkin carving template
    docs/templates/pumpkin-carving-template.pdf (built from the .html next
    to it) has two pages of instructions plus actual-size outlines for the
    13" craft pumpkin: round 1.5" eyes 3" apart (a NeoPixel Jewel fits
    behind each), a 6" x 2" grin sized for the C920's view and mics, and a
    5" x 7" back hatch with a cable notch for one Z150 speaker. It includes
    a scale-check ruler, starter-hole marks and paper slit marks.
    PROP_BUILD.md links it and now states the same sizes, and its webcam
    aim (level to about 10 degrees up at 26-30") matches the template.
2026-10-18 Jacques talks kid-first; drop the accent push; he's a critic, not a chef
    - Persona: every greeting starts kid-first (name the costume and one
    detail in plain words, a big silly rating, at most one short food
    joke, two or three sentences). The full food-critic routine ("flavor
    notes", "presentation", "finish") is only for people who clearly play
    along, such as a grown-up asking for a review; mixed or unsure groups
    stay kid-first. The camera never judges age, so this keys off the
    conversation.
    - Reverts the accent instructions (they didn't produce an accent and the
    "cartoon chef" wording made him sound like a chef), keeping the extra
    French interjections.
    - PROP_BUILD and the B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
2026-10-18 More variety and simpler words: stop "ooh la la, five pumpkins out of five"
    Of 81 creature lines in a day of testing, 26 said "ooh la la" and 33
    "out of five": the persona's examples all used them, and every greeting
    request read the same, so the model settled into one groove (each new
    session starts with no memory of the last).
    - Persona: a pool of French exclamations and verdict styles, a "never
    repeat yourself" rule ("ooh la la" at most once per visit), varied
    example lines, and simple words a four-year-old knows (big words only
    in the grown-up critic routine; no "mysterious civilian look").
    - Code: each greeting request gets a random, character-neutral style
    twist (an opening an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
2026-10-18 Name each costume's standout detail and praise it in greetings
    The vision model now reports one specific, delightful detail per costume
    ("standout: glow-in-the-dark bones"), still costumes and props only, with
    the word limit raised from 70 to 80. GREETING and FOLLOW_UP ask the creature
    to praise that detail so every compliment is specific. SAME/NEW/CHANGED
    verdict format is unchanged.
2026-10-18 Add operator quick modes and a costume gallery
    Quick modes: one-tap dashboard buttons (Candy's low, Candy's out, Toddler
    mode, Back in 5, Last call) that send standing instructions to the voice
    session until turned off. Engines get setStanding(), which re-applies the
    modes to every new session. On/off state is remembered for the evening in
    localStorage, and each toggle is logged to the Conversation panel and the
    on-disk log.
    Costume gallery: /api/session-logs/<day>/gallery.html builds a grid and
    slideshow from the day's log.txt: each greeting snapshot with its vision
    caption and the creature's best nearby line. Linked from the dashboard and
    the All logs page, with a family-only privacy note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
2026-10-18 Add one-shot eye flourishes: greeting sparkle, gasp, thinking slow blink
    New firmware command `F sparkle|gasp|slowblink` overlays a timed animation
    (0.9-1.4 s) on the current state, then returns to normal:
    - sparkle: spinning rainbow around each jewel's ring with white twinkles,
    fading back over the last 300 ms (plain LEDs: brightness-only twinkle,
    alternating eyes)
    - gasp: two quick blinks, then wide-eyed, easing back
    - slowblink: lids drift shut, rest, drift open
    All colors stay under MAX_BRIGHTNESS; the 2 s fail-safe also cancels a
    flourish. Unknown effects answer `ERR flourish`.
    Server: encodeFlourish() and BodyController.flourish() (sent straight
    through, never replayed on reconnec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
2026-10-18 Add rehearsal mode: pretend visitors from sample images
    A developer panel under Settings simulates visitors without walking into
    frame. Pick sample images (uploads kept in memory, or greeting snapshots
    from a day's log), then Visitor arrives / Leaves / Swap to next image /
    Second visitor joins / Run script (arrive, 20 s, swap, 10 s, leave, 15 s,
    return).
    It plugs in behind two small seams in main.ts, the frame source and the
    detections fed to the tracker, so the real VisitorTracker, Director,
    voice and vision APIs run unchanged. While it's on, the real detector
    isn't run and a "REHEARSAL — not the real camera" banner covers the video.
    Logs: rehearsal vision lines and conversation lines a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
2026-10-18 Add a dashboard voice picker with a server-side voice allowlist
    A Voice panel lists every voice the engine can use, with what OpenAI's
    docs say (language, regional influence, presentation, source; checked
    2026-10-18) and our own testing notes. English voices come first. The
    pick is remembered per engine in localStorage and sent with each new
    session; precedence is dashboard pick > VOICE in .env > the character's
    default. The server only passes allowlisted voices to OpenAI and logs
    and ignores anything else. A new voice applies from the next session,
    with a "Restart voice session now" button while one is running.
2026-10-18 Add phone remote, dashboard watchdog and health alerts
    - Phone remote at /remote (server-served, works in dev and production): status,
    kill switch, Greet now, Make it say, quick modes, alerts, log links. Commands
    relay through the server to the dashboard (SSE + POST); the dashboard checks in
    every 2 s with its status, which doubles as its heartbeat.
    - LAN access only with REMOTE_PIN (then listens on 0.0.0.0). Non-loopback requests
    need a PIN session cookie (HttpOnly, SameSite=Strict) for all /api and /ws routes;
    constant-time PIN check, per-client and global rate limits; dashboard-only routes
    (sessions, vision, Arduino) stay local. Origin check kept; Host check defeats
    DNS rebi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
2026-10-18 Lure mode and spooky ambience between visitors
    Two local-audio features that never open the billed voice session:
    - Lure mode: when the porch is empty and someone is in view but too far
    to count, play one of 14 pre-recorded call-outs ("Psst! Over here!
    Come get your costume reviewed!"). Random clip, never the same twice
    in a row, 45 s cooldown plus jitter (configurable in Settings), and a
    30 s wait after visitors or the creature talked.
    - Spooky ambience: creaky door, owl, thunder, wind, cackle, wolf howl
    and bell, synthesized with Web Audio at low volume every 20-60 s.
    Both stop at once when someone comes close or the creature speaks,
    respect the kill switch, play through the se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
2026-10-18 Docs: README feature overview and current setup; drop the stale debug handoff
2026-10-18 Docs: bring README, DESIGN, PLAN, build guide, Pi mode and parts lists up to date
    - README: a "what it does" overview, current quick start (no old branch),
    plan-B audio, unattended-night pointers, LOG_DIR/LOG_SNAPSHOTS in the
    config table, characters' games flag, and troubleshooting for echo,
    faint/humming speakers and flat voices.
    - DESIGN: new system diagram (speaker on a USB sound card, phone remote,
    ntfy, watchdog), operator controls (modes, spookiness, voice), logs and
    gallery, remote/alerts/watchdog, rehearsal mode, plain-LED eyes, safety
    and an honest known-limits list.
    - PLAN: milestones as they stand (first Mac run done, night-of features
    built; prop build, NeoPixels,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
2026-10-18 Big-group mode, and tidy the shared prompt's no-costume and spookiness rules
    Big groups (4+ visitors, or a group that has grown twice in one visit, a
    line forming) get one quick group welcome, a shout-out to one or two
    standout costumes and one fun group moment, with no mini-game, instead of
    costume-by-costume compliments. The Director passes the tracker's count and
    grow count with each greeting; GPT-Live also reads a head count stated in
    the vision description and takes the larger. Both engines log "big group (N)".
    Group openings and finishes have their own never-twice-in-a-row variety.
    base.md: the no-costume line no longer suggests "mysterious civilian look"
    (which pumpkin.md forbade), a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
2026-10-18 Snapshot privacy: retention, off switch and delete-all
    - SNAPSHOT_RETENTION_DAYS (default 7, 0/off keeps forever): at server
    start and then daily, delete snapshot photos of day folders older than
    that. log.txt is kept; log.html gets a "photo removed after N days"
    placeholder. Deletes only snapshot-named regular files in real LOG_DAY
    folders inside the resolved log dir, never following symlinks.
    - SNAPSHOTS=off writes no frames; the caption is logged as a "look" line
    so the gallery still shows it in words, with a "snapshots are turned
    off" note. LOG_SNAPSHOTS=false still works.
    - Dashboard: current policy under the log links and a confirmed
    "Delete all snapshots now" (POST /api/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
2026-10-18 Night recap: morning-after summary page and one end-of-night push
    server/recap.ts builds a recap of one night from the day's log.txt (rehearsal
    lines skipped): visitor groups and a rough people count (method explained on
    the page), the busiest half hour with a CSS bar chart, one top costume per
    group (NEW greetings with vivid "standout:" details first, near-duplicates
    dropped, deleted snapshots shown as placeholders), the creature's best lines,
    and awake / on-duty time.
    Served at /recap/<day> (and /recap for the latest evening) behind the existing
    access guard: this computer, or a phone signed in with REMOTE_PIN; an unsigned
    phone is sent to the PIN page. Linked from the dashboard, the remo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
2026-10-18 Offline fallback, clip-driven eyes, and recorded clips in the session voice
    Offline mode: when the voice session can't start (error, no network, or not
    open within 5 s of an arrival) or drops mid-visit, the Director plays bundled
    recorded greetings (16 costume-agnostic lines for Jacques, never the same one
    twice in a row, at most one per 20 s), owes the live greeting, and retries with
    backoff (5 s doubling to 60 s), switching back as soon as a session opens. Going
    offline and recovering are logged and raise a voice-offline alert (one ntfy
    push per 15 min). The server and browser now time out hung session requests.
    Eyes: recorded clips feed a voice tap measured by a second VoiceMeter, so the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
2026-10-18 Soak test: a whole Halloween evening at high speed against a mock OpenAI
    `npm run soak` runs the real server (production build, BODY_SERIAL_PORT=none,
    temp logs, .env ignored) pointed at a local mock of the OpenAI endpoints, and
    the real dashboard in headless Chrome (fake camera and mic, rehearsal mode,
    WebRTC replaced by a fake GPT-Live session), driven over CDP. It plays a
    seeded 4-hour evening compressed into about 75 minutes, plus phone-remote
    presses, reconnecting log and remote streams, a stalled reader and an OpenAI
    outage, and samples server and browser memory, timers, streams, disk and
    stalls, with pass/fail checks and CSV/JSON output.
    Fixes for what it found:
    - The Conversation pa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
2026-10-24 docs: how to hide the webcam's activity lights inside the pumpkin
    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
2026-10-25 Eye preview: draw both NeoPixel Jewels pixel by pixel, as the firmware lights them
    Each preview eye is now a Jewel 7 board with its seven LEDs (center plus a
    ring of six). The per-pixel colors follow the firmware's renderEyes():
    the sparkle's rainbow ring, white center flash and random twinkles, and the
    idle candle flicker drifting toward random targets.
    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
2026-10-26 Eyes: animate each of the Jewels' LEDs on its own
    Each NeoPixel now gets its own brightness and hue every frame, in the
    character's colors, with the two eyes turning in mirror image:
    - thinking: a comet spins round the ring, its tail fading and drifting in hue
    - listening: a soft bright spot circles slowly round a steady center
    - speaking: brightness follows the voice, with a warm ripple going round
    - idle: a candle flicker per LED (flicker), or a slow hue swirl (glow/blink)
    - sleeping: a faint ember drifting round
    Flourishes play on top as before. The firmware's pixelMotion() and the
    dashboard preview (web/eyeFlourish.ts) share the same math. The firmware
    also reads serial input halfway thr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
2026-10-26 Eyes spin faster the louder he talks; CI compiles the firmware and runs the checks
    While speaking, the ripple round each Jewel now goes round at a speed that
    follows the voice (0.4 turns a second when quiet, 3 when loud), on top of
    brightness following it. The firmware and the dashboard preview share the
    rate (speakSpinRate).
    Adds a GitHub Actions workflow: on every pull request and on main, it runs
    the tests, typecheck and build, and compiles the firmware for the Uno with
    all warnings, in both NeoPixel and plain-LED modes.
    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
2026-10-27 Body link: talk to the Arduino at 38400 baud so NeoPixel frames don't eat commands
    eyes.show() turns interrupts off for ~0.4 ms every frame. At 115200 baud
    bytes arriving in that window are lost: on the bench about 1 command in 20
    came through mangled ("S thinking" arrived as "S king"). At 38400 a byte
    takes longer than the blackout, so the UART holds it: 0 of 600 lost.
    The traffic is a few hundred bytes a second, so the slower link is free.
    BODY_BAUD in server/body/protocol.ts is the one source for the server; a
    test checks the firmware's Serial.begin() matches it.
2026-10-27 Livelier eyes: blinks, deeper speaking range, and a whirl on loud words
    While speaking:
    - brightness drops to 10% between words (was 35%), and the ripple round
    the ring is deeper;
    - a dark purple lid sweeps down over each eye and back up (375 ms)
    every 3-6 s;
    - the ripple whirls about 1.5 extra turns in 0.6 s when the voice jumps
    loud, at most every 5 s and at least every 9 s.
    Idle and sleeping eyes blink a black lid every 4-8 s; listening and
    thinking keep their own motion. EYE_TOP_PIXEL says which ring LED is on
    top as the Jewels are mounted.
    LivelyEyes in web/eyeFlourish.ts drives the dashboard preview the same
    way livelyStep() drives the firmware, and a test checks their timings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
2026-10-27 Eyes: one black lid for every blink, and keep idle from falling asleep
    - Speaking blinks use the same black lid as idle and sleeping; purple
    didn't read as a blink.
    - The thinking (and ambience) "slowblink" flourish is now that same lid
    blink. It used to fade every LED to fully dark for 0.3 s over the
    spinning comet, which looked like a glitch.
    - The dashboard re-sends the body state every second even when it hasn't
    changed. The server only heartbeats for 3 s after the page's last
    message, so a steady state (idle with nobody talking) let the
    Arduino's 2 s fail-safe drop the eyes to sleeping. A test drives the
    real BodyLink into BodyController for 20 s of idle to cover it.
    The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
2026-10-27 Idle eyes: a spark racing round the rings and a purple pulse in the center
    Idle (awake, nobody there) was too subtle. Now:
    - every 3-7 s a warm white spark with a short tail races twice round
    each ring in 1.6 s, easing in and out, from a random pixel and a
    random way round (the eyes in mirror image);
    - the center breathes toward dark purple and back every 3.2 s;
    - the pumpkin's idle color is a bright version of its sleeping ember
    (#ff3d00, was #ff6a00).
    The candle flicker and the black blinks are unchanged. LivelyEyes in
    web/eyeFlourish.ts and livelyStep() in the firmware schedule the spins
    the same way, and a test checks their timings and colors match.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
2026-10-27 Revert "Idle eyes breathe: 5 s bright, 1 s down to a glow, 1 s back"
    On the real pumpkin the dip read too much like a blink. The spark, the
    purple center pulse and the autopilot fix stay.
    This reverts commit e6d4bfa.
2026-10-27 Eyes: the gasp's two quick blinks are lids too
    The welcome-back gasp dimmed every LED together for its two quick
    blinks, like the old thinking blink did. Now they're the same black lid
    as every other blink, sped up to 150 ms each (GASP_BLINK_MS); the
    wide-eyed part after is unchanged.
2026-10-27 Body: only one dashboard drives the eyes
    Each open dashboard re-sends its state every second, so with two open
    (say one awake, one forgotten and asleep) the eyes flipped between them.
    The server now follows one: the newest awake dashboard, or the newest if
    none is awake (BodyClients in server/body/driver.ts). When the leader
    changes it replays the new one's palette and state, and logs it when
    more than one dashboard is open.
2026-10-27 Pumpkin: Jacqueline O'Lantern, with gleam as her default voice
    The owner likes the gleam voice best, and it's feminine, so the pumpkin
    is now Jacqueline O'Lantern (the persona has no other gendered words:
    her hat, spectacles and bow tie stay). Her default GPT-Live voice is
    gleam (was meridian) and her realtime voice marin (was cedar).
    - Alerts, the nightly recap, the remote page, the gallery and the docs
    use her name (and she/her where they said he/his).
    - The bundled recorded clips are re-read in marin, with "I'm Jacqueline
    the pumpkin" (scripts/make-lure-clips.ts), so the no-network fallback
    matches her too.
    - The carving template PDF is rebuilt from its HTML with headless
    Chrome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
2026-10-27 Director: keep the mic on for 20 s after visitors "leave"
    The camera loses people who stand close, at the edge of the frame or in
    the dark (tonight's log: "Visitors left", then "Someone's here after
    19-33 s", with vision saying "partially visible" / "too dark"). The mic
    muted the moment they "left", so whatever they said in that gap never
    reached her. Now "left" schedules the mute for micGraceMs (20 s) later;
    an arrival or return cancels it, and the kill switch still mutes at once.
2026-10-31 Eyes: match how the Jewels are mounted (flat top, pixel 1 at 9 o'clock)
    The pumpkin's Jewels sit with a pair of pixels at the top (2 and 3) rather
    than pixel 1 straight up. EYE_TOP_PIXEL is now 2.5, so the lid comes straight
    down over that top pair, and the ripples, comet and idle spark mirror the two
    eyes left to right across it (before, they mirrored across pixel 1, which is
    now at 9 o'clock). The dashboard preview draws its jewels turned the same way.
2026-10-31 Live engine: "Make it say…" speaks right away
    Operator lines went out as session.instructions.append, which in GPT-Live
    only steers later turns, so she never said them. Send them as
    session.commentary.append, the same way greetings are spoken.
2026-10-31 Body: reconnect to the Arduino once, and keep the port that opened
    Unplugging the Arduino fired both an error and a close, and each started its
    own reconnect. Both opened the port; the second lost with "Cannot lock port"
    but was the one the sink kept, so every line after that (modes, colors,
    states, the greeting sparkle) went nowhere and the eyes sat in the fail-safe
    sleeping look until the server restarted.
    Now there's one pending reconnect at a time, a port is claimed while it
    opens, and a port that fails to open (or closes) is let go and retried.
    The serialport module can be passed in, and new tests replay the unplug.
2026-10-31 Dashboard: open the exact microphone chosen in Settings, and say which
    The mic was opened with deviceId { ideal }, and Chrome on the Mac quietly
    handed back the MacBook's built-in mic instead of the webcam in the pumpkin,
    even with the webcam chosen in Settings and set as the Mac's default input.
    She couldn't hear visitors at the porch. Now it asks for { exact } (falling
    back to the default, with a log line, if that device is gone) and logs
    "Listening through: <mic>", plus a warning if it isn't the one in Settings.
2026-10-31 Dashboard: a Mic boost setting for a mic that hears visitors faintly
    The webcam sits inside the pumpkin and hears visitors at talking distance
    about 20 dB too quietly, so she only heard someone shouting into the mouth.
    Settings gets Mic boost (Off, 2x, 4x, 8x; changing it reloads the page):
    the mic goes through a gain stage after the browser's echo cancelling.
    With a boost on, Chrome's own gain control is off, so it stops turning
    the mic's input volume down underneath the boost. Off is unchanged.
